Jake-ston/Beefy_Adressable_Lights/PDFs/Schematic.pdf

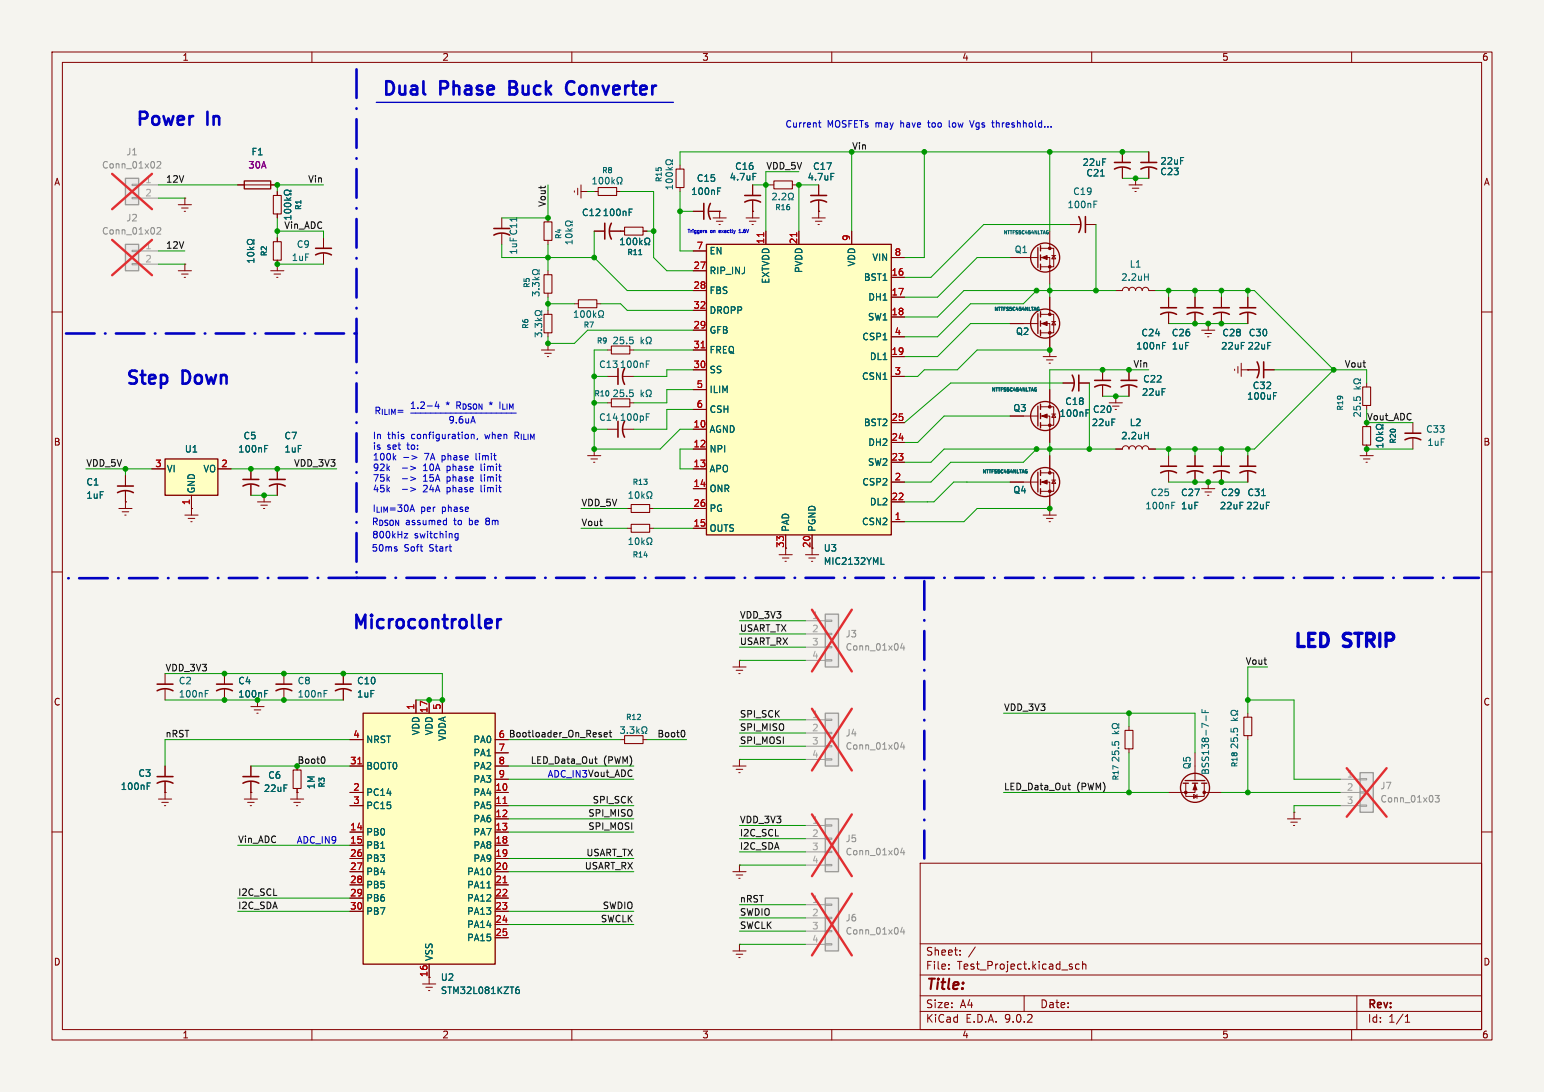
[picture p1: page 1]

Dual Phase Buck Converter

Id: 1/1 Title: File: Test_Project.kicad_sch Sheet: / R15 þÿ100k©
