Jake-ston/Beefy_Adressable_Lights/PDFs/Test_Project.pdf

3V3 SWCLK GND MISO Din UART_TX GND - GND
