Jake-ston/Beefy_Adressable_Lights/Test_Project.kicad_pcb

## KiCad design Test_Project.kicad_pcb (2025-07-08)

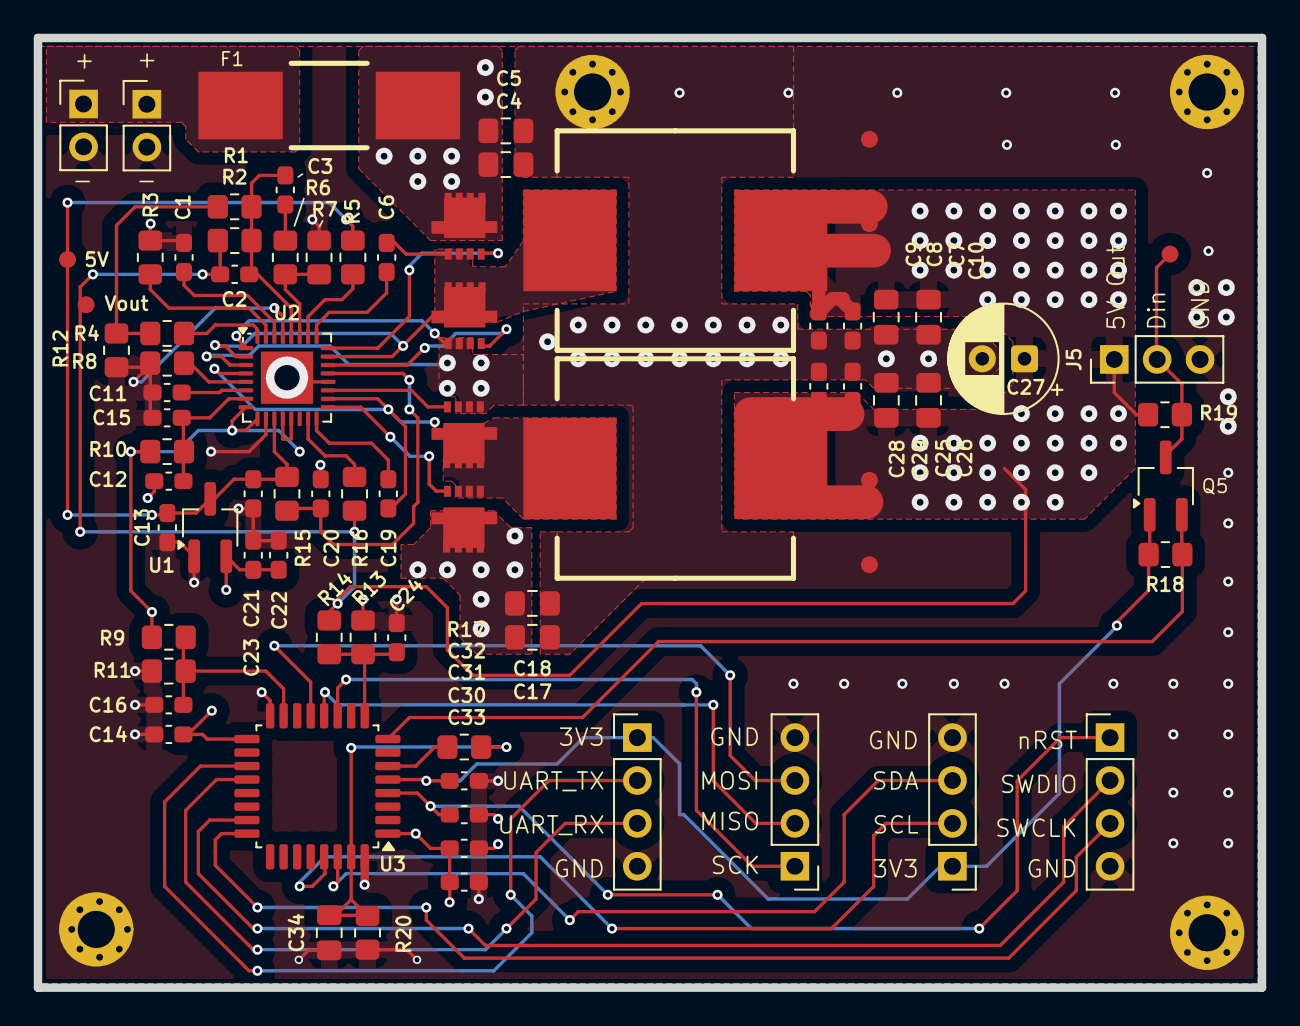
[picture p2: board Test_Project.kicad_pcb from above]

Board: 4 copper layers, 72.5 x 56.2 mm, 72 parts (0 on the bottom side), 44 nets.

Parts:
C1, C3, C6, C9, C12, C14, C19, C23, C28, C30, C31, C32: 100nF; C_0603_1608Metric_Pad1.08x0.95mm_HandSolder
C2, C8, C13, C16, C22, C24, C29, C33: 1uF; C_0603_1608Metric_Pad1.08x0.95mm_HandSolder
C4, C5, C7, C10, C17, C18, C25, C26, C34: 22uF; C_0805_2012Metric_Pad1.18x1.45mm_HandSolder
C11: 100pF; C_0603_1608Metric_Pad1.08x0.95mm_HandSolder
C15: ?uF; C_0603_1608Metric_Pad1.08x0.95mm_HandSolder
C20, C21: 4.7uF; C_0603_1608Metric_Pad1.08x0.95mm_HandSolder
C27: 100uF; CP_Radial_D6.3mm_P2.50mm
F1: 0678L9300-02; Fuse - 0678L9300-02
J1, J2: Conn_01x02; PinHeader_1x02_P2.54mm_Vertical
J3, J4, J6, J7: Conn_01x04; PinHeader_1x04_P2.54mm_Vertical
J5: Conn_01x03; PinHeader_1x03_P2.54mm_Vertical
L1, L2: 2.2uH; SRP1265A
Q1, Q2, Q3, Q4: NTTFS5C454NLTAG
Q5: BSS138-7-F
R1, R12, R17: 3.3kΩ; R_0805_2012Metric_Pad1.20x1.40mm_HandSolder
R2, R5, R11, R13, R16: 10kΩ; R_0805_2012Metric_Pad1.20x1.40mm_HandSolder
R3, R8, R14, R18, R19: 25.5 kΩ; R_0805_2012Metric_Pad1.20x1.40mm_HandSolder
R4, R6, R7, R9, R10: 100kΩ; R_0805_2012Metric_Pad1.20x1.40mm_HandSolder
R15: 2.2Ω; R_0805_2012Metric_Pad1.20x1.40mm_HandSolder
R20: 1M; R_0805_2012Metric_Pad1.20x1.40mm_HandSolder
U1: AP2127N-3.3TRG1; SOT-23W_Handsoldering
U2: MIC2132YML; QFN-32-1EP_5x5mm_P0.5mm_EP3.1x3.1mm
U3: STM32L081KZT6; LQFP-32_7x7mm_P0.8mm

Connections:
/12V: F1.1, J1.1, J2.1
/Boot0: C34.1, R17.2, R20.1, U3.31 (BOOT0)
/Bootloader_On_Reset: R17.1, U3.6 (PA0)
/I2C_SCL: J7.2, U3.29 (PB6)
/I2C_SDA: J7.3, U3.30 (PB7)
/LED_Data_Out (PWM): Q5.2 (S), R18.1, U3.8 (PA2)
/SPI_MISO: J6.2, U3.12 (PA6)
/SPI_MOSI: J6.3, U3.13 (PA7)
/SPI_SCK: J6.1, U3.11 (PA5)
/SWCLK: J4.3, U3.24 (PA14)
/SWDIO: J4.2, U3.23 (PA13)
/USART_RX: J3.3, U3.20 (PA10)
/USART_TX: J3.2, U3.19 (PA9)
/VDD_3V3: C14.1, C22.1, C23.1, C30.1, C32.1, C33.1, J3.1, J7.1, Q5.3 (G), R18.2, U1.2 (VO), U3.1 (VDD), U3.5 (VDDA), U3.17 (VDD)
/VDD_5V: C13.1, C21.1, R5.2, R15.2, U1.3 (VI), U2.11 (EXTVDD)
/Vin: C4.1, C5.1, C17.1, C18.1, F1.2, Q1.1 (D), Q4.1 (D), R9.2, R10.2, U2.8 (VIN), U2.9 (VDD)
/Vin_ADC: C16.1, R9.1, R11.2, U3.15 (PB1)
/Vout: C2.1, C7.1, C8.1, C9.1, C10.1, C25.1, C26.1, C27.1, C28.1, C29.1, J5.1, L1.2, L2.2, R2.2, R14.2, R16.1, R19.2
/Vout_ADC: C24.1, R13.2, R14.1, U3.9 (PA3)
/nRST: C31.1, J4.1, U3.4 (NRST)
GND: C1.1, C4.2, C5.2, C7.2, C8.2, C9.2, C10.2, C11.1, C12.2, C13.2, C14.2, C15.2, C16.2, C17.2, C18.2, C20.2, C21.2, C22.2, C23.2, C24.2, C25.2, C26.2, C27.2, C28.2, C29.2, C30.2, C31.2, C32.2, C33.2, C34.2, J1.2, J2.2, J3.4, J4.4, J5.3, J6.4, J7.4, Q2.2 (S), Q3.2 (S), R3.1, R7.2, R8.1, R11.1, R12.1, R13.1, R20.2, U1.1 (GND), U2.1 (CSN2), U2.3 (CSN1), U2.10 (AGND), U2.20 (PGND), U2.29 (GFB), U2.33 (PAD), U3.16 (VSS), U3.32 (VSS)
unnamed: C3.2, R6.2
unnamed: J5.2, Q5.1 (D), R19.1
unnamed: Q4.3 (G), U2.17 (DH1)
unnamed: C19.1, L2.1, Q3.1 (D), Q4.2 (S), U2.4 (CSP1), U2.18 (SW1)
unnamed: Q3.3 (G), U2.19 (DL1)
unnamed: Q1.3 (G), U2.24 (DH2)
unnamed: C6.1, L1.1, Q1.2 (S), Q2.1 (D), U2.2 (CSP2), U2.23 (SW2)
unnamed: Q2.3 (G), U2.22 (DL2)
unnamed: R1.1, R4.2, R12.2
unnamed: U2.12 (NPI), U2.13 (APO)
unnamed: C19.2, U2.16 (BST1)
unnamed: C6.2, U2.25 (BST2)
unnamed: C11.2, U2.6 (CSH)
unnamed: R4.1, U2.32 (DROPP)
unnamed: C12.1, C15.1, R10.1, U2.7 (EN)
unnamed: C2.2, C3.1, R1.2, R2.1, U2.28 (FBS)
unnamed: R3.2, U2.31 (FREQ)
unnamed: R8.2, U2.5 (ILIM)
unnamed: R16.2, U2.15 (OUTS)
unnamed: R5.1, U2.26 (PG)
unnamed: C20.1, R15.1, U2.21 (PVDD)
unnamed: R6.1, R7.1, U2.27 (RIP_INJ)
unnamed: C1.2, U2.30 (SS)
