Jake-ston/Beefy_Adressable_Lights/(commit log)

2025-05-27 First commit. Nothing functional, just testing things out.
    [Test_Project.kicad_pcb, Test_Project.kicad_sch]
2025-05-27 Learned how to export footprints to local library so things are portable. PCB editor -> export -> footprints to library Modified .gitignore to keep track of this library
    [Test_Project.kicad_pcb]
2025-05-28 Daily commit
    [Test_Project.kicad_sch]
2025-05-29 Added a local symbol library to match how the PCB footprints are stored. Again, with portability in mind.
    This update of footprints and schematic symbols should be done whenever something else is added.
    [Test_Project.kicad_sch]
2025-05-30 Worked on switching converter portion of schematic. Still needs deciding: RDROOP Cout RIlim Cin Bootstrap caps MOSFETs
    MOSFET based level shifter for the LED strip.
    [Test_Project.kicad_sch]
2025-05-30 Finished up buck section of schematic minus the mosfet choice. Also moved around things on the schematic and added an optional electrolytic capacitor
    [Test_Project.kicad_sch]
2025-05-30 Added values to the input decoupling capacitors on the top set of fets
    [Test_Project.kicad_sch]
2025-05-30 Finished up schematic
    [Test_Project.kicad_pcb, Test_Project.kicad_sch]
2025-05-30 Added part number for transistors. Need to create footprint and reconsider R_{ILIM}
    [Test_Project.kicad_sch]
2025-06-02 Added preliminary footprint for the MOSFETs
    [Test_Project.kicad_sch]
2025-06-02 Started PCB layout
    [Test_Project.kicad_pcb, Test_Project.kicad_sch]
2025-06-03 Removed the 12V jack, added another 0.1" header in parallel so more current can be achieved if there are issues. Did most of the PCB layout. Updated some footprints
    [Test_Project.kicad_pcb, Test_Project.kicad_sch]
2025-06-03 Finished up routing nets and pouring polygons. Needs final ground pours and review before ordering.
    [Test_Project.kicad_pcb, Test_Project.kicad_sch]
2025-06-05 Added BOM and digikey cart order.
    [Order Quantity for 2.csv, Test_Project.csv]
2025-06-05 Finished up layout and added some mounting holes.
    [Test_Project.kicad_pcb, Test_Project.kicad_sch]
2025-06-05 Daily commit. Working through test points and DRC checks.
    [Test_Project.kicad_pcb, Test_Project.kicad_sch]
2025-06-09 Modified footprints, redid silkscreen designators to be geographical on PCB rather than on schematic (experimental) Started process of DRC. Will need to check against JLC's requirements (should be go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
    [Test_Project.kicad_pcb]
2025-06-13 Updated footprint 3d models in local library.
    [Test_Project.kicad_pcb]
2025-06-17 Generated gerbers and drill files
    [Test_Project.kicad_pcb]
2025-07-08 Generated PDFs
    [Test_Project.kicad_pcb]
